micovi/stakee/models/inserts/README.md

<!-- Generated by `uv run stakee-build`. Edit the generator, not this file. -->

# Inserts

Drop-in trays that turn a crate into a kit: dev-board dock, solder station, parts grid.

[All models](../README.md) · 3 parts · rebuild with `uv run stakee-build --only inserts` · source: [`stakee/modules/inserts.py`](../../stakee/modules/inserts.py)

## Parts

| Preview | Part | Size (mm) | Material | Download |
| --- | --- | --- | --- | --- |
| Dev-board dock | **Dev-board dock**<br>Holds a Pi Zero / Zero 2 W and a Pico on locating pegs and an ESP32 DevKitC in an edge cradle, 10 mm off the floor so header tails never take the weight. | 120.9 × 78.9 × 14.4 | PLA or PETG | [STL](stl/dev-board-dock.stl) · [STEP](step/dev-board-dock.step) |
| Solder station insert | **Solder station insert**<br>Pockets for a 10 ml flux syringe (lying diagonally), a 40 mm wick reel on a spin axle with a feed slot, a 22 mm solder tube and a 30 mm tip-tinner tin. | 120.9 × 78.9 × 20 | PETG or ASA (it lives next to the iron); never rest the hot tip on any print | [STL](stl/solder-station.stl) · [STEP](step/solder-station.step) |
| Small-parts grid 4x4 | **Small-parts grid 4x4**<br>Lift-out tray of sixteen 18 mm cups with 5 mm scooped floors for SMD parts, screws and standoffs; swap whole trays between crates. | 78.9 × 78.9 × 14 | PLA or PETG | [STL](stl/parts-grid-2x2.stl) · [STEP](step/parts-grid-2x2.step) |

## Print notes

- **Dev-board dock**: Plate on the bed, no supports, 0.2 mm layers, 3 walls, 15% infill. Pegs are 2.35/1.7 mm: print slower for the top 3 mm or ream with a drill.
- **Solder station insert**: Upright, no supports, 3 walls, 10-15% infill. Round trough bottoms print as steep overhangs and come out fine; the 1 mm ribs between pockets need 0.4 mm nozzle.
- **Small-parts grid 4x4**: Upright, no supports, 2 walls, 15% infill.

## How it works

Drop-in inserts: trays that sit on a crate floor and turn a generic crate into a kit.

Every insert is modelled in its own frame (centered on XY, bottom at z = 0) and is
meant to sit at z = FLOOR_Z inside the crate it names. Inserts keep CLEARANCE per side
to the cavity walls and stay below the stacking seat (`size.lip_top - SEAT_DEPTH`),
so a crate or cap still stacks on top.
