micovi/stakee/models/baglib/step/cap-2x4.step

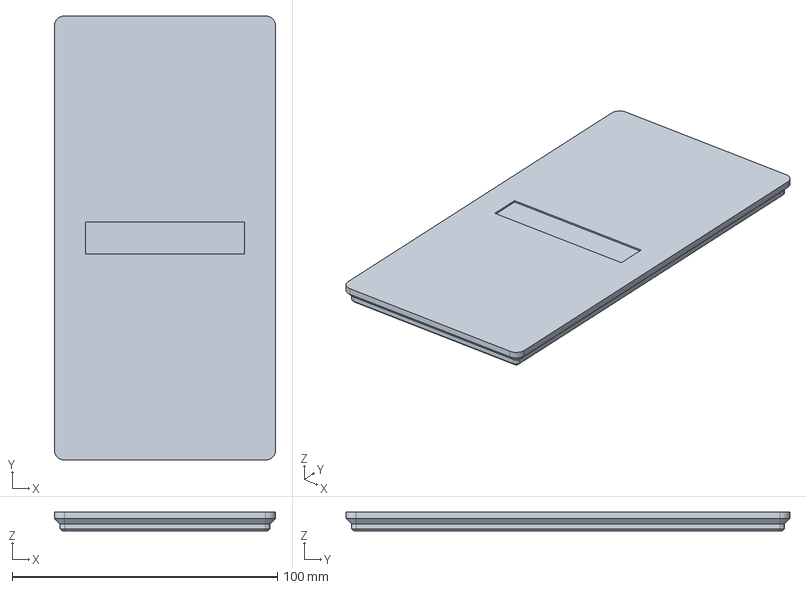
[picture p1: CAD file, 2026-10-02]
models/baglib/step/cap-2x4.step
83.5 x 167.5 x 7.15 mm
