micovi/stakee/models/calibration/step/lip-coupon-15.step

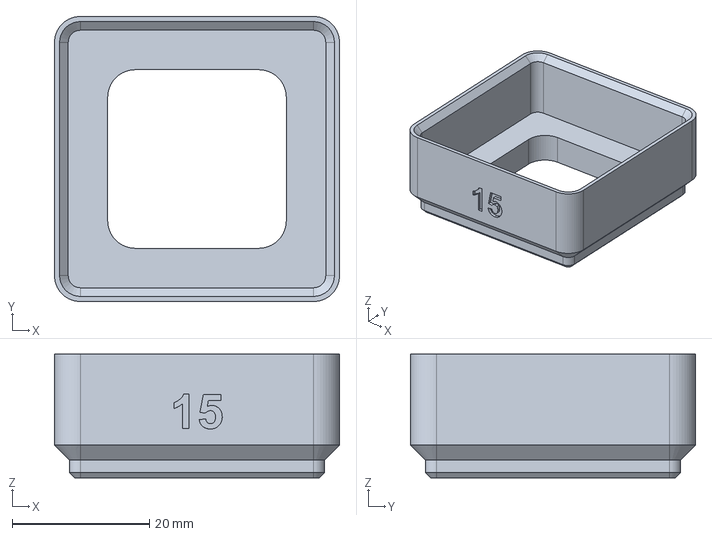
[picture p2: CAD file, 2026-10-02]
models/calibration/step/lip-coupon-15.step
41.5 x 41.5 x 18.0 mm
