micovi/stakee/models/crates/step/cap-2x2.step

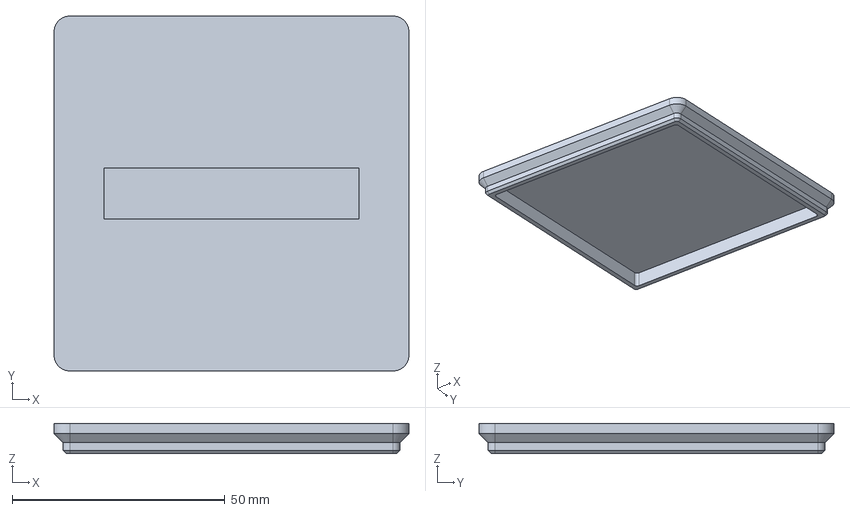
[picture p3: CAD file, 2026-10-02]
models/crates/step/cap-2x2.step
83.5 x 83.5 x 7.15 mm
