micovi/stakee/models/dividers/step/rail-x-3x2x6.step

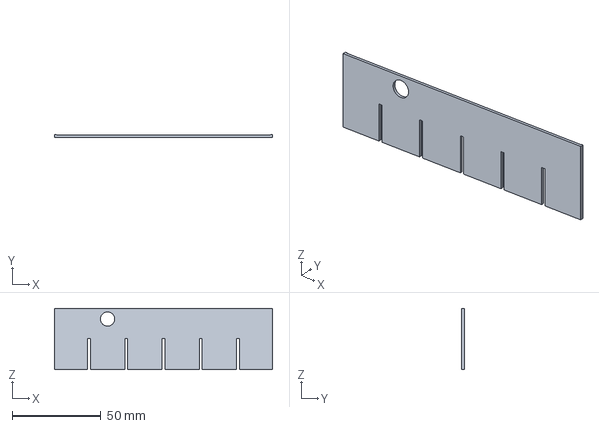
[picture p4: CAD file, 2026-10-02]
models/dividers/step/rail-x-3x2x6.step
122.7 x 1.50 x 34.5 mm
