micovi/stakee/models/drawers/step/sleeve-2x2x6.step

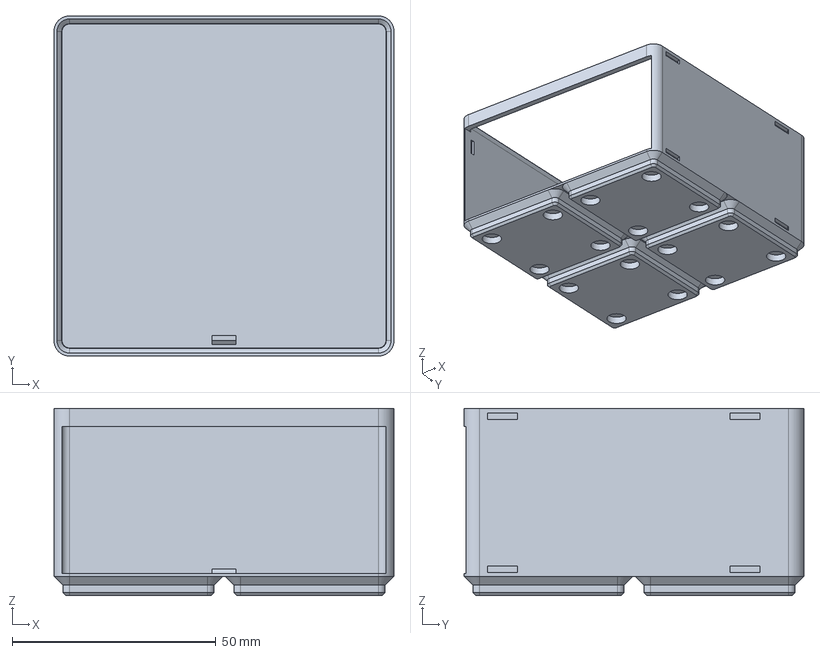
[picture p5: CAD file, 2026-10-02]
models/drawers/step/sleeve-2x2x6.step
83.5 x 83.5 x 46.0 mm
