micovi/stakee/models/esd/step/esd-crate-3x2x6.step

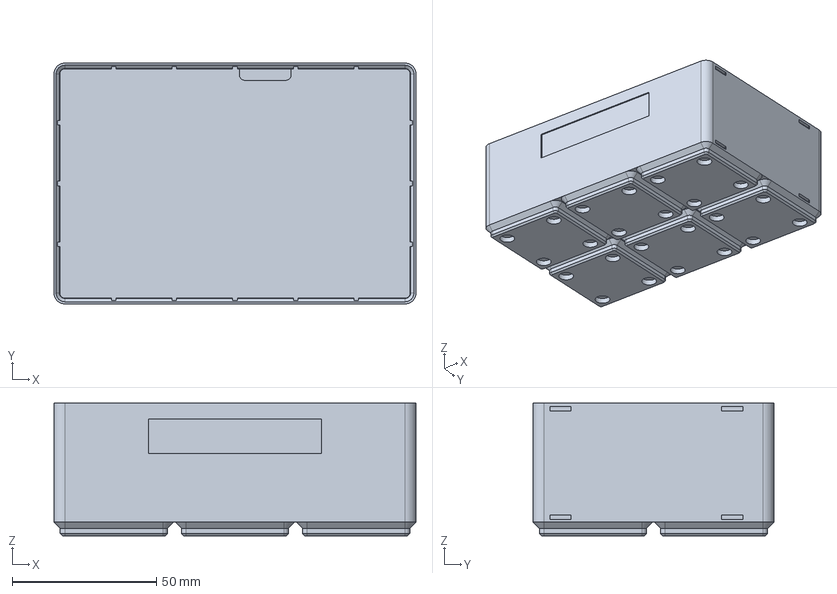
[picture p6: CAD file, 2026-10-02]
models/esd/step/esd-crate-3x2x6.step
125.5 x 83.5 x 46.0 mm
