micovi/stakee/models/inserts/step/parts-grid-2x2.step

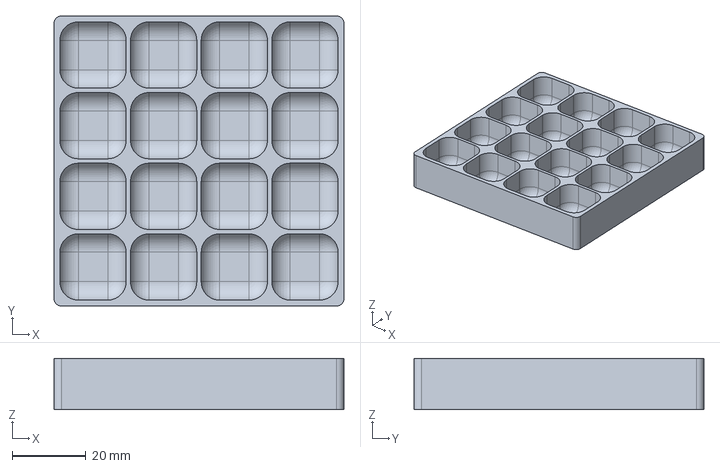
[picture p7: CAD file, 2026-10-02]
models/inserts/step/parts-grid-2x2.step
78.9 x 78.9 x 14.0 mm
