micovi/stakee/models/kit/step/nfc-label-tile.step

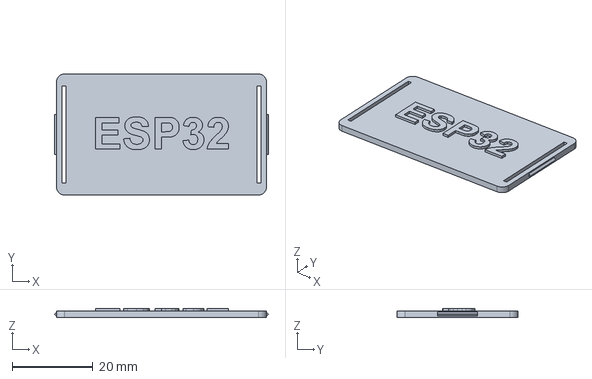
[picture p8: CAD file, 2026-10-02]
models/kit/step/nfc-label-tile.step
53.0 x 30.0 x 2.20 mm
