micovi/stakee/models/magtray/step/magtray-3x2.step

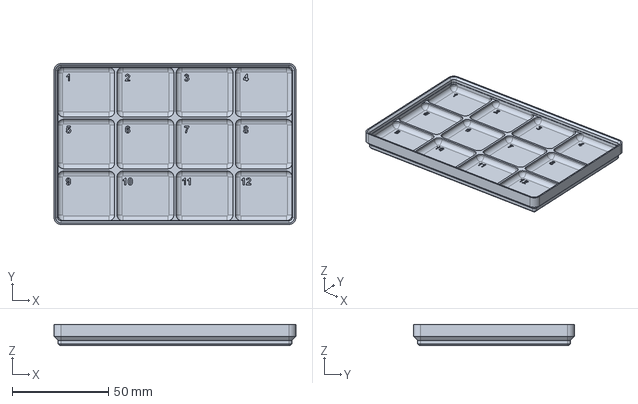
[picture p9: CAD file, 2026-10-02]
models/magtray/step/magtray-3x2.step
125.5 x 83.5 x 11.0 mm
