micovi/stakee/models/pocket/step/pocket-base-2x2x4.step

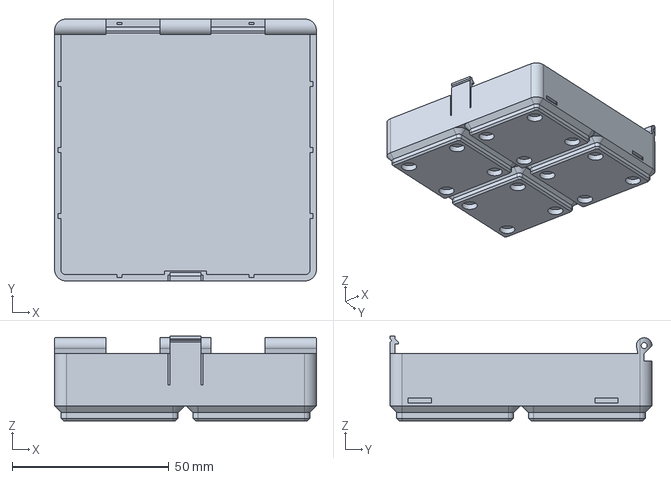
[picture p10: CAD file, 2026-10-02]
models/pocket/step/pocket-base-2x2x4.step
83.5 x 83.5 x 27.0 mm
