micovi/stakee/models/wallrail/step/wall-cleat-2.step

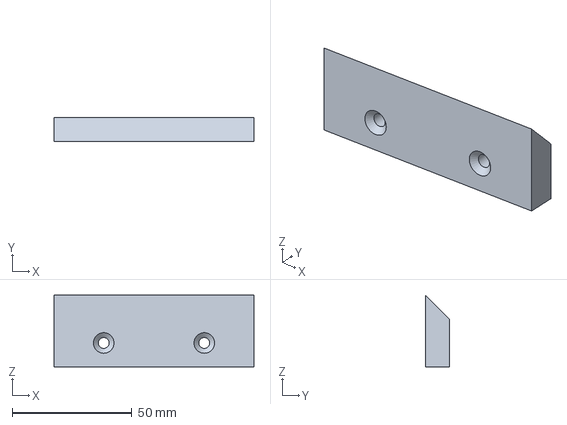
[picture p11: CAD file, 2026-10-02]
models/wallrail/step/wall-cleat-2.step
83.5 x 10.0 x 30.0 mm
