micovi/stakee/models/wirespool/step/wire-dispenser-4x2x9.step

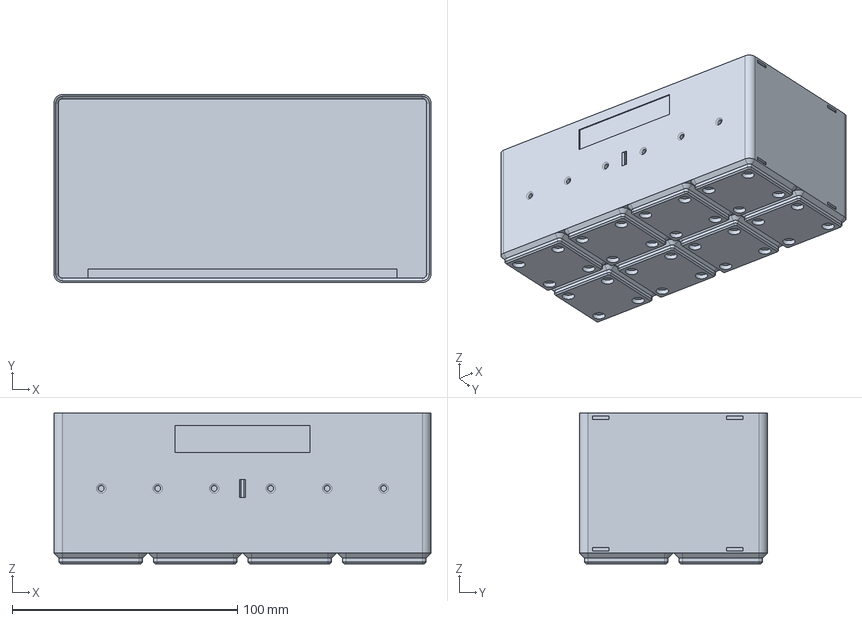
[picture p12: CAD file, 2026-10-02]
models/wirespool/step/wire-dispenser-4x2x9.step
167.5 x 83.5 x 67.0 mm
