micovi/stakee/models/baglib/step/card-4x-mcu.step

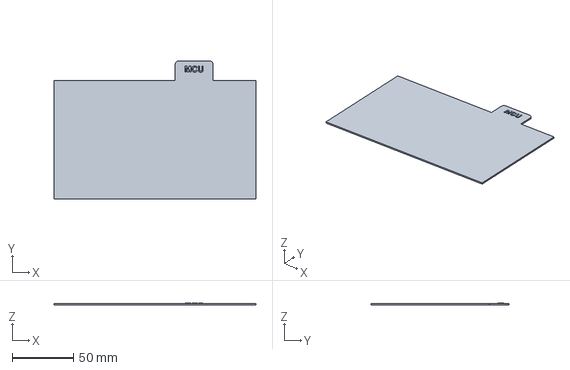
[picture p13: CAD file, 2026-10-02]
models/baglib/step/card-4x-mcu.step
164.7 x 112.9 x 1.60 mm
