micovi/stakee/models/calibration/step/slot-strip.step

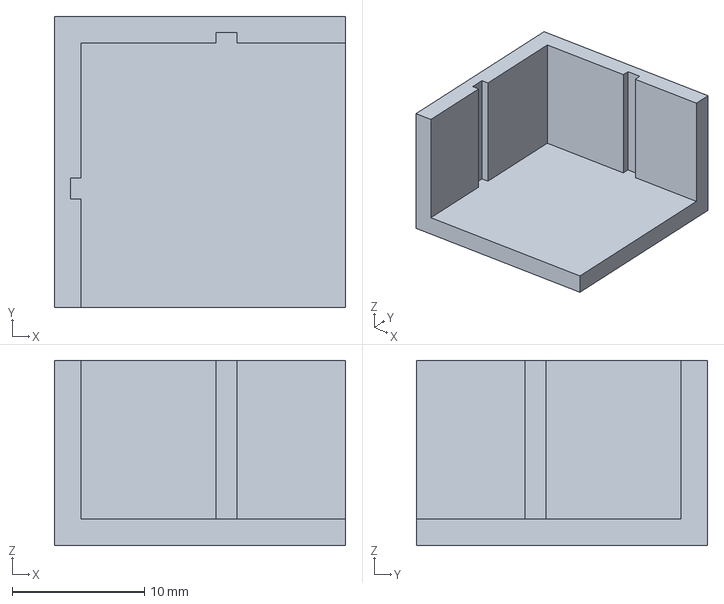
[picture p14: CAD file, 2026-10-02]
models/calibration/step/slot-strip.step
22.0 x 22.0 x 14.0 mm
