micovi/stakee/models/crates/step/crate-2x1x3.step

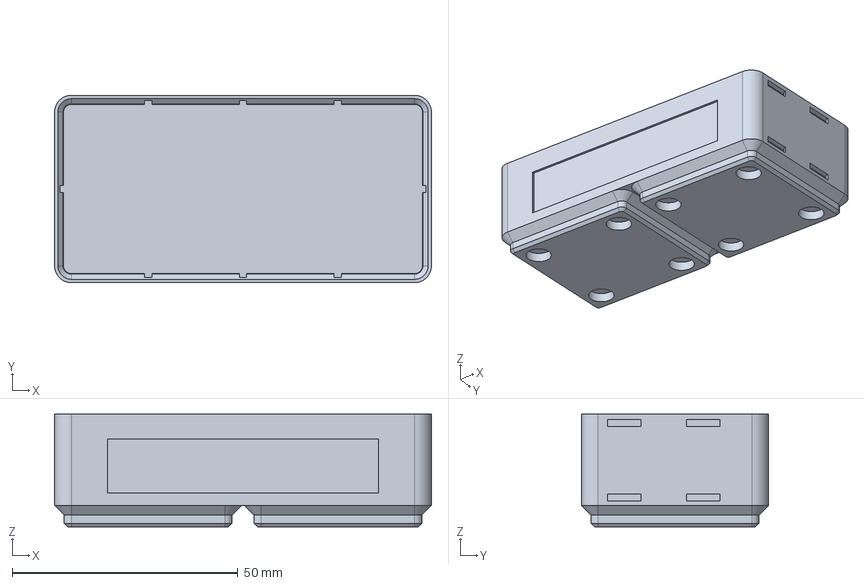
[picture p15: CAD file, 2026-10-02]
models/crates/step/crate-2x1x3.step
83.5 x 41.5 x 25.0 mm
