micovi/stakee/models/dividers/step/bridge-42-3x2x6.step

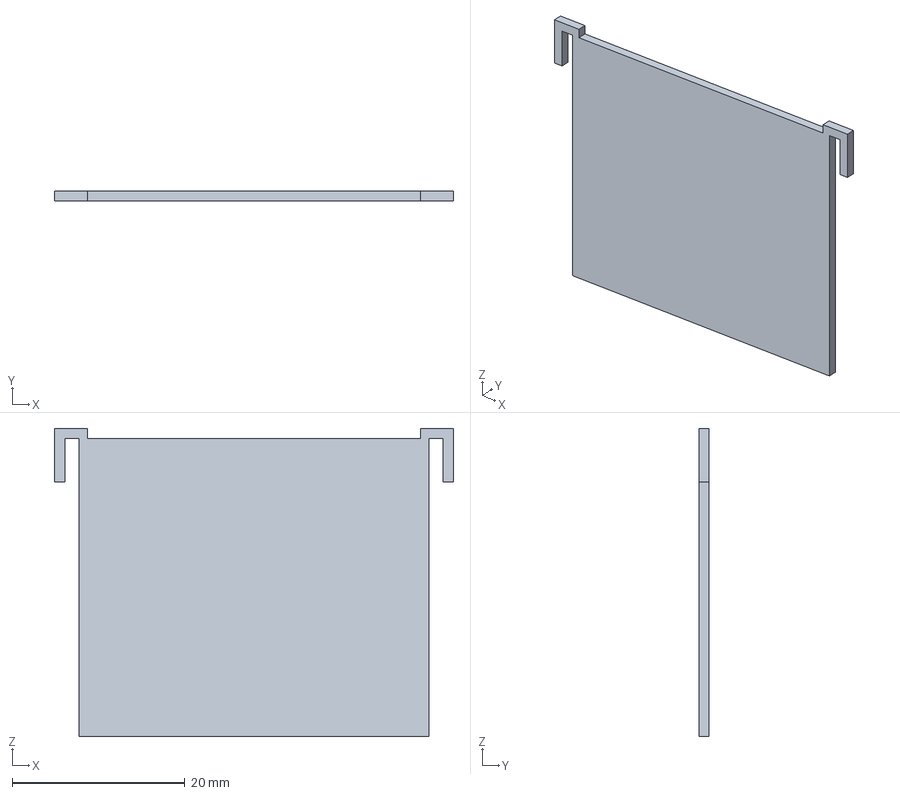
[picture p16: CAD file, 2026-10-02]
models/dividers/step/bridge-42-3x2x6.step
46.2 x 1.20 x 35.7 mm
