micovi/stakee/models/drawers/step/drawer-2x2x6.step

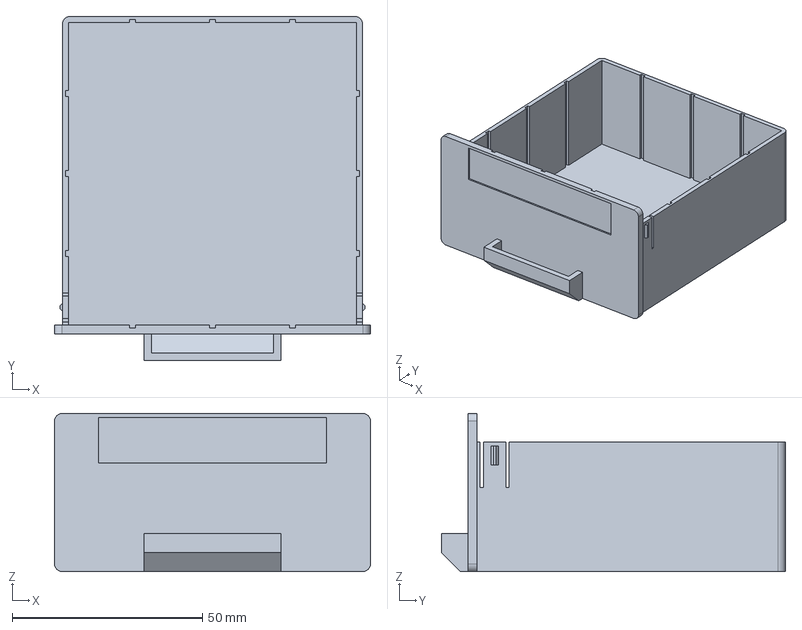
[picture p17: CAD file, 2026-10-02]
models/drawers/step/drawer-2x2x6.step
83.0 x 90.4 x 41.5 mm
