micovi/stakee/models/esd/step/esd-crate-2x2x3.step

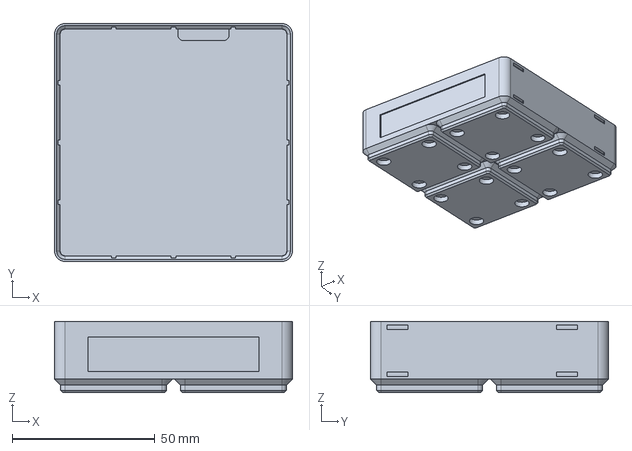
[picture p18: CAD file, 2026-10-02]
models/esd/step/esd-crate-2x2x3.step
83.5 x 83.5 x 25.0 mm
