micovi/stakee/models/inserts/step/dev-board-dock.step

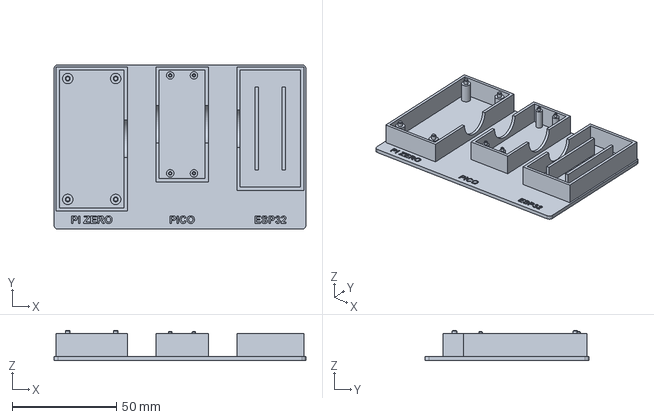
[picture p19: CAD file, 2026-10-02]
models/inserts/step/dev-board-dock.step
120.9 x 78.9 x 14.4 mm
