micovi/stakee/models/kit/step/tool-rack-cap-2x2.step

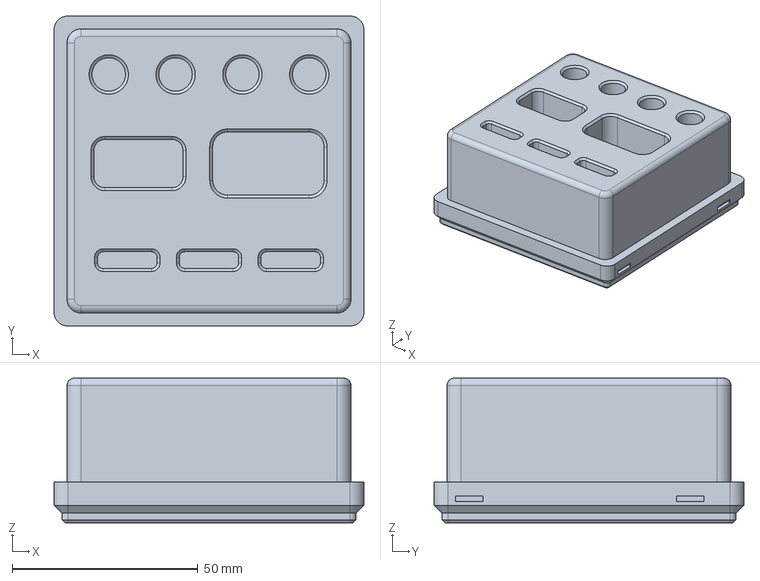
[picture p20: CAD file, 2026-10-02]
models/kit/step/tool-rack-cap-2x2.step
83.5 x 83.5 x 39.0 mm
