micovi/stakee/models/magtray/step/magtray-2x2.step

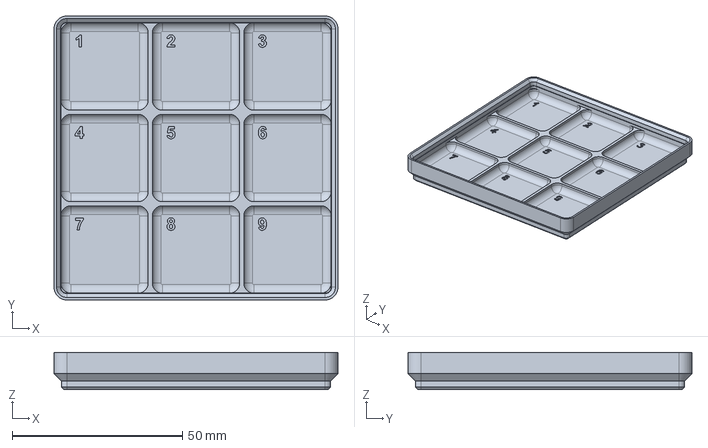
[picture p21: CAD file, 2026-10-02]
models/magtray/step/magtray-2x2.step
83.5 x 83.5 x 11.0 mm
