micovi/stakee/models/pocket/step/pocket-base-2x1x4.step

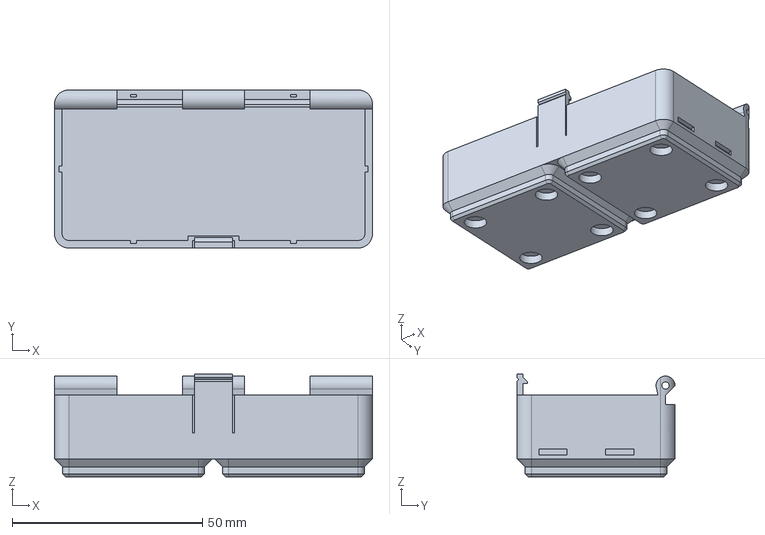
[picture p22: CAD file, 2026-10-02]
models/pocket/step/pocket-base-2x1x4.step
83.5 x 41.5 x 27.0 mm
