micovi/stakee/models/wallrail/step/wall-cleat-4.step

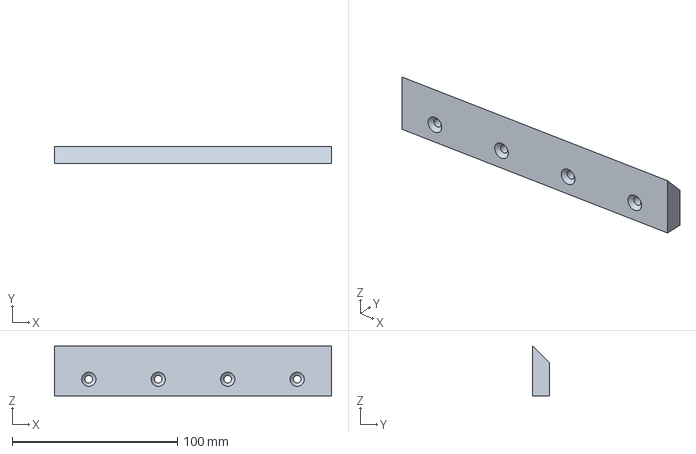
[picture p23: CAD file, 2026-10-02]
models/wallrail/step/wall-cleat-4.step
167.5 x 10.0 x 30.0 mm
