micovi/stakee/models/wirespool/step/wire-cradle-frame-4x2x9.step

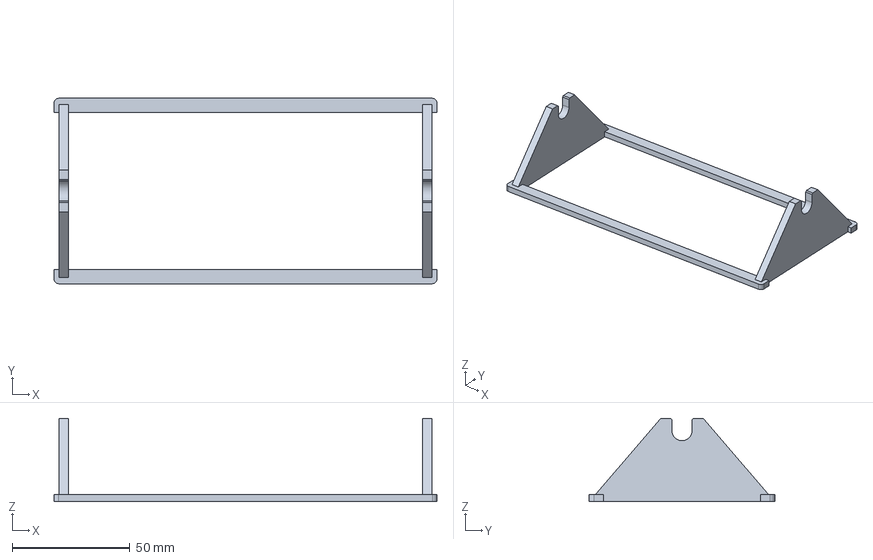
[picture p24: CAD file, 2026-10-02]
models/wirespool/step/wire-cradle-frame-4x2x9.step
162.9 x 78.9 x 35.5 mm
