micovi/stakee/models/baglib/step/card-2x-res.step

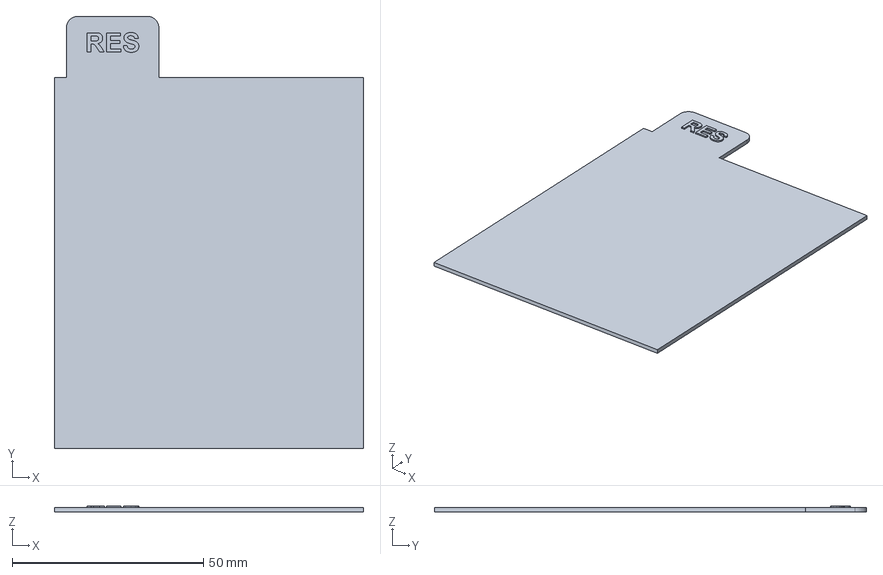
[picture p25: CAD file, 2026-10-02]
models/baglib/step/card-2x-res.step
80.7 x 112.9 x 1.60 mm
