micovi/stakee/models/calibration/step/lip-probe.step

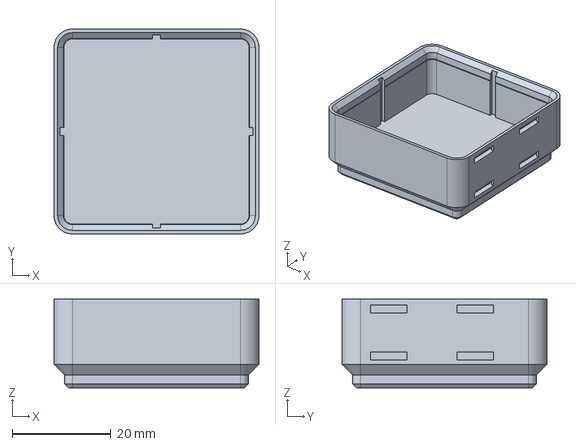
[picture p26: CAD file, 2026-10-02]
models/calibration/step/lip-probe.step
41.5 x 41.5 x 18.0 mm
