micovi/stakee/models/drawers/step/rail-y-drawer-2x2x6.step

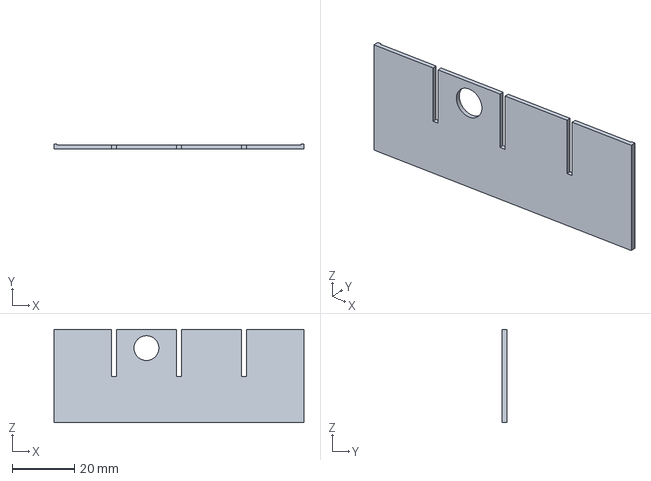
[picture p27: CAD file, 2026-10-02]
models/drawers/step/rail-y-drawer-2x2x6.step
80.6 x 1.50 x 30.0 mm
