micovi/stakee/models/esd/step/esd-crate-2x2x6.step

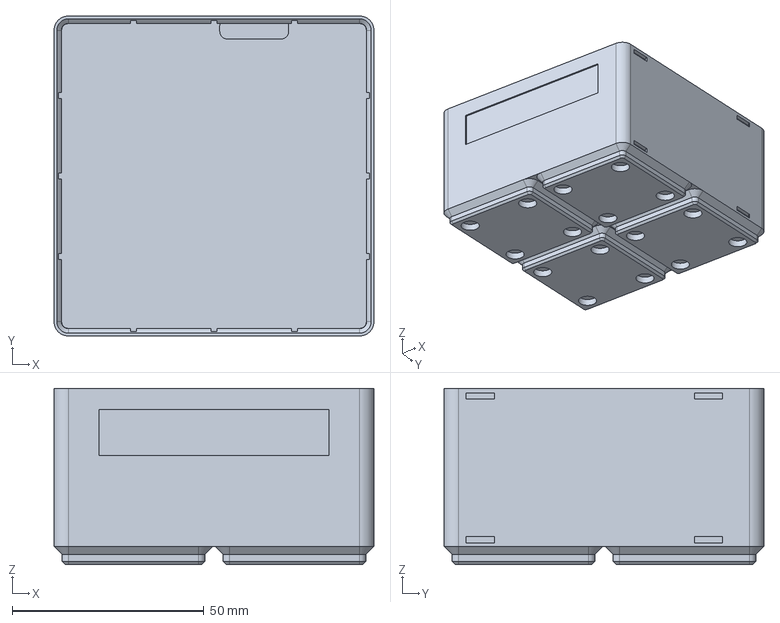
[picture p28: CAD file, 2026-10-02]
models/esd/step/esd-crate-2x2x6.step
83.5 x 83.5 x 46.0 mm
