micovi/stakee/models/inserts/step/solder-station.step

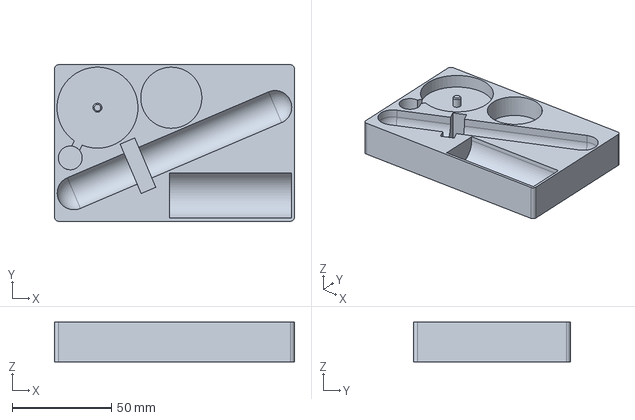
[picture p29: CAD file, 2026-10-02]
models/inserts/step/solder-station.step
120.9 x 78.9 x 20.0 mm
