micovi/stakee/models/pocket/step/pocket-divider-2x2.step

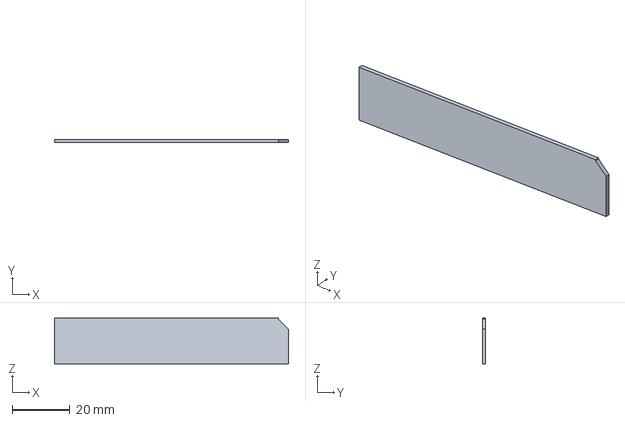
[picture p31: CAD file, 2026-10-02]
models/pocket/step/pocket-divider-2x2.step
80.7 x 1.20 x 15.7 mm
