micovi/stakee/models/wallrail/step/shelf-2x1.step

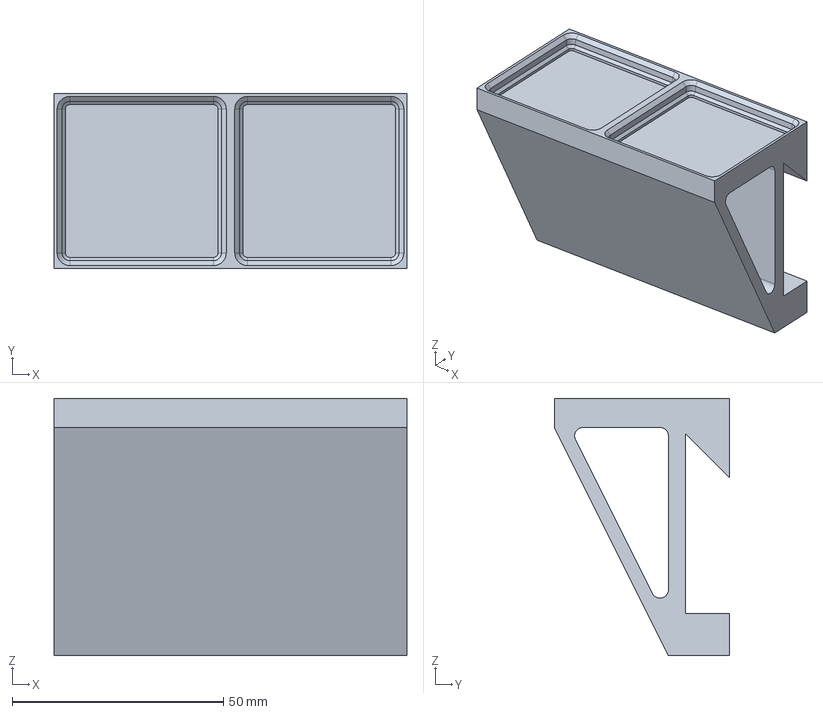
[picture p32: CAD file, 2026-10-02]
models/wallrail/step/shelf-2x1.step
83.5 x 41.5 x 60.9 mm
