micovi/stakee/models/wirespool/step/wire-axle-8mm.step

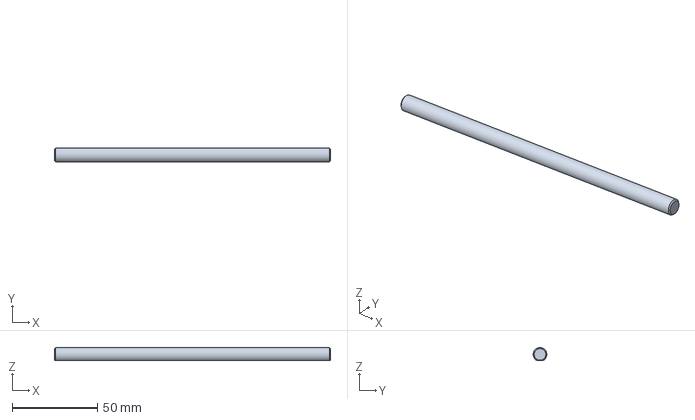
[picture p33: CAD file, 2026-10-02]
models/wirespool/step/wire-axle-8mm.step
161.5 x 7.99 x 7.49 mm
