micovi/stakee/models/calibration/step/lip-coupon-35.step

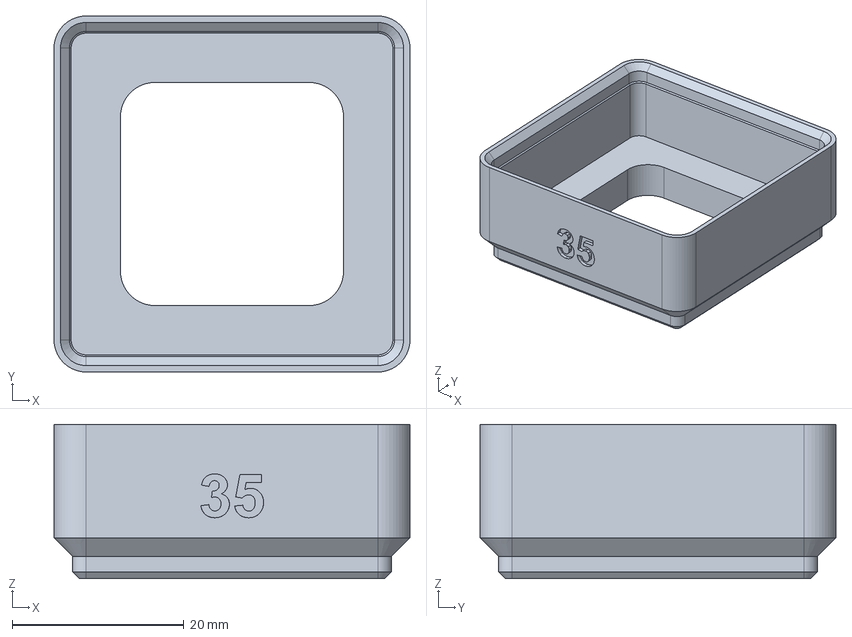
[picture p34: CAD file, 2026-10-02]
models/calibration/step/lip-coupon-35.step
41.5 x 41.5 x 18.0 mm
