micovi/stakee/models/dividers/step/rail-y-2x2x3.step

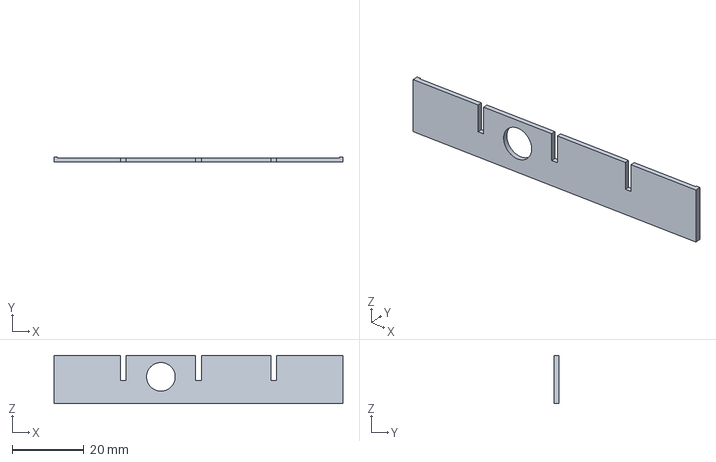
[picture p35: CAD file, 2026-10-02]
models/dividers/step/rail-y-2x2x3.step
80.7 x 1.50 x 13.5 mm
