micovi/stakee/models/drawers/step/drawer-2x2x3.step

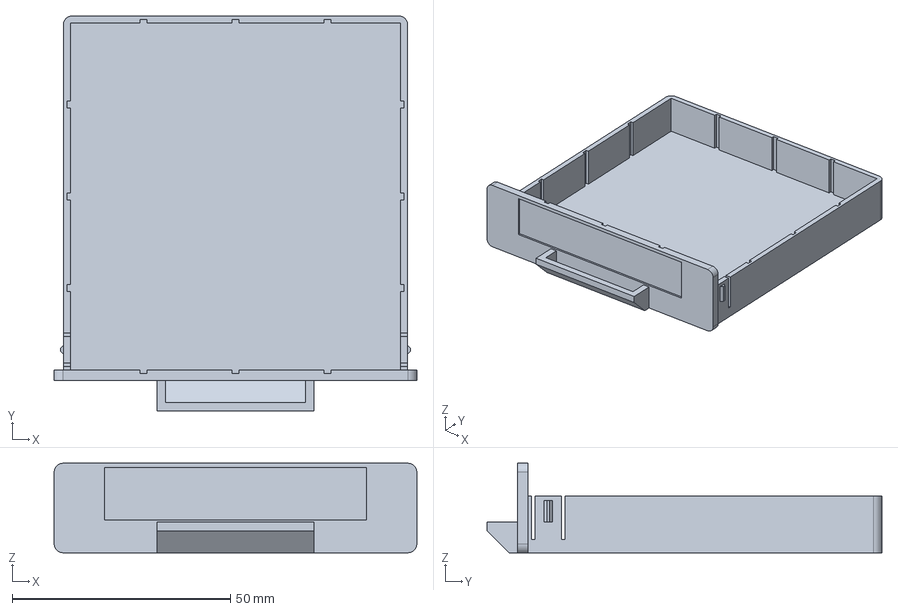
[picture p36: CAD file, 2026-10-02]
models/drawers/step/drawer-2x2x3.step
83.0 x 90.4 x 20.5 mm
