micovi/stakee/models/kit/step/tote-cap-2x2.step

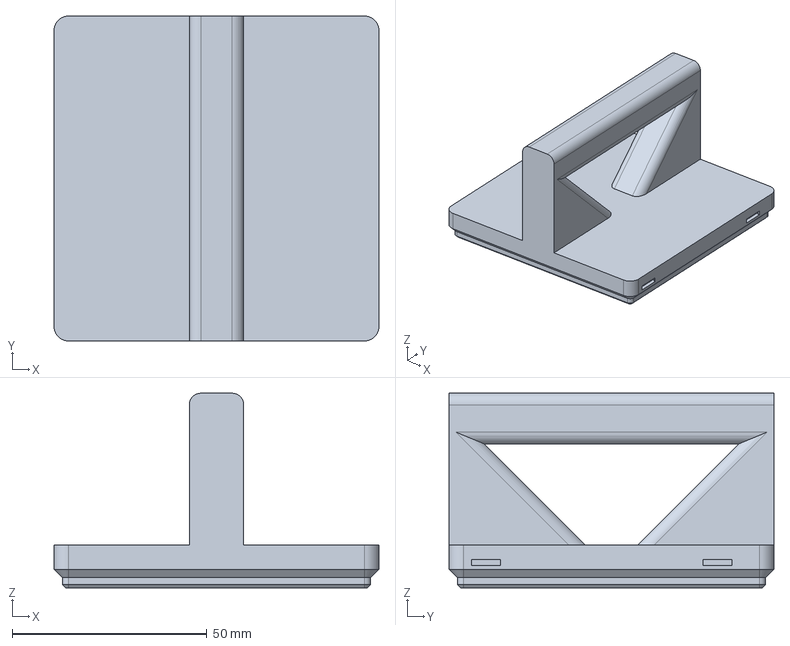
[picture p37: CAD file, 2026-10-02]
models/kit/step/tote-cap-2x2.step
83.5 x 83.5 x 50.0 mm
