micovi/stakee/models/pocket/step/pocket-lid-2x1.step

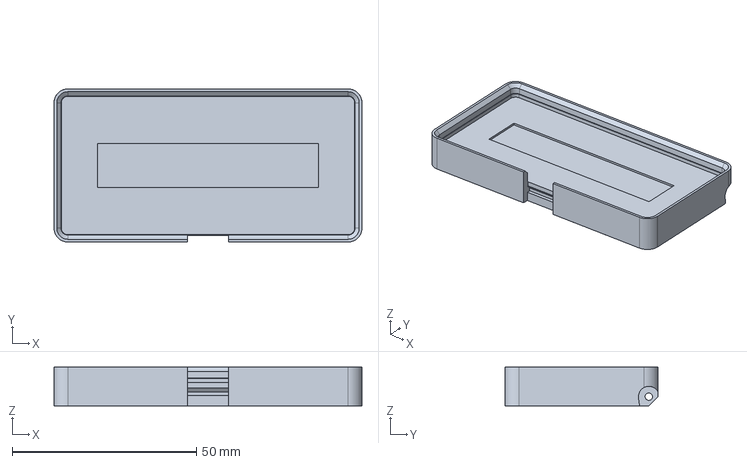
[picture p38: CAD file, 2026-10-02]
models/pocket/step/pocket-lid-2x1.step
83.5 x 41.5 x 10.5 mm
