micovi/stakee/models/wallrail/step/shelf-3x2.step

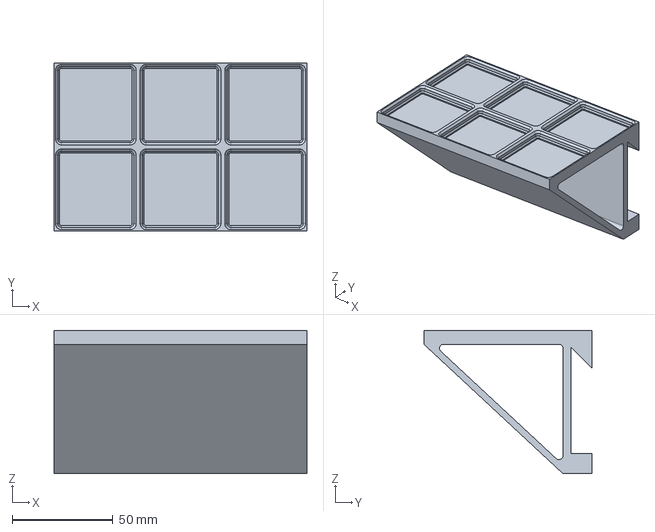
[picture p39: CAD file, 2026-10-02]
models/wallrail/step/shelf-3x2.step
125.5 x 83.5 x 71.1 mm
