micovi/stakee/models/crates/step/cap-2x1.step

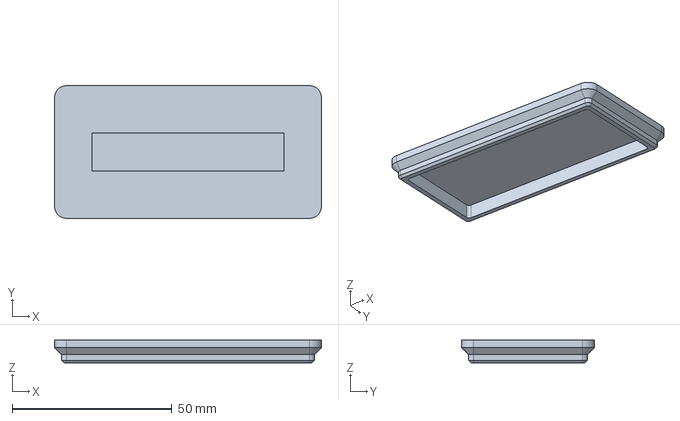
[picture p40: CAD file, 2026-10-02]
models/crates/step/cap-2x1.step
83.5 x 41.5 x 7.15 mm
