micovi/stakee/models/dividers/step/hook-42-2x2x3.step

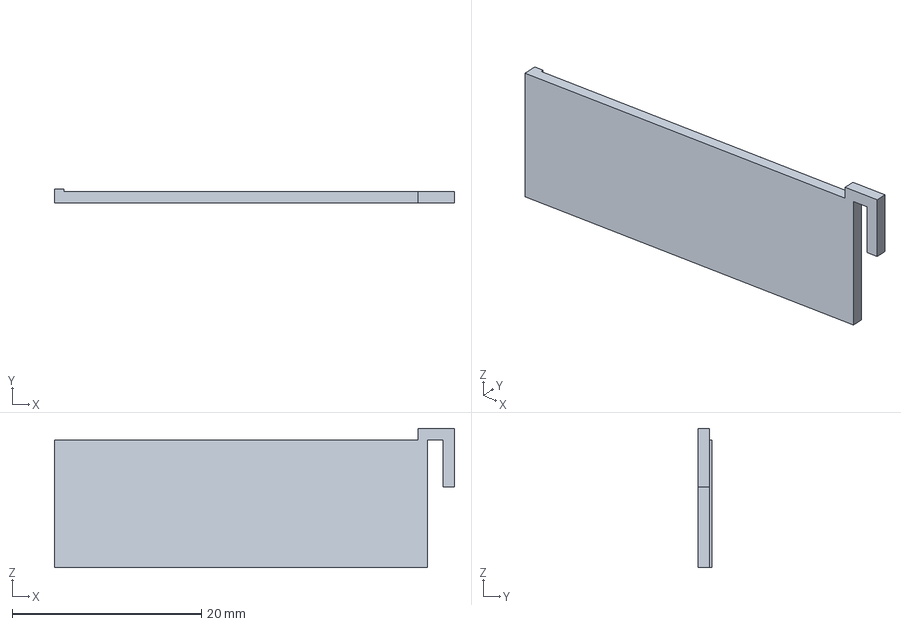
[picture p41: CAD file, 2026-10-02]
models/dividers/step/hook-42-2x2x3.step
42.3 x 1.50 x 14.7 mm
