micovi/stakee/models/drawers/step/rail-x-drawer-2x2x3.step

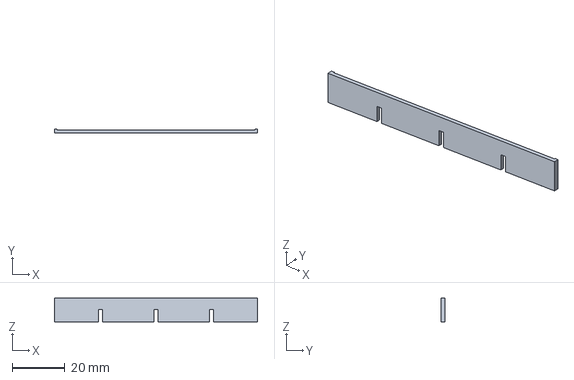
[picture p42: CAD file, 2026-10-02]
models/drawers/step/rail-x-drawer-2x2x3.step
76.8 x 1.50 x 9.00 mm
