micovi/stakee/models/kit/step/nfc-cap-2x2.step

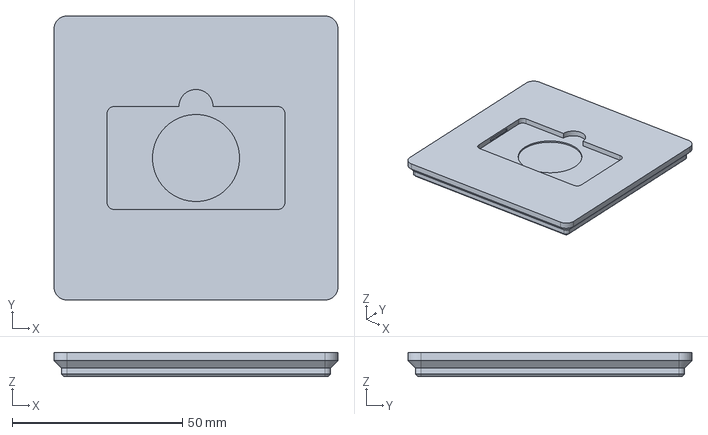
[picture p43: CAD file, 2026-10-02]
models/kit/step/nfc-cap-2x2.step
83.5 x 83.5 x 7.15 mm
