micovi/stakee/models/pocket/step/pocket-divider-2x1.step

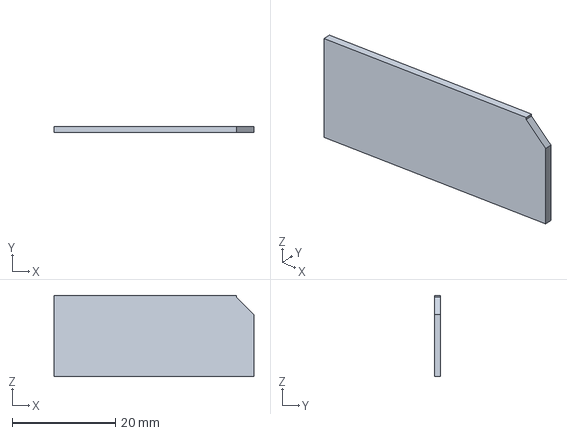
[picture p44: CAD file, 2026-10-02]
models/pocket/step/pocket-divider-2x1.step
38.7 x 1.20 x 15.7 mm
