micovi/stakee/models/wallrail/step/shelf-4x1.step

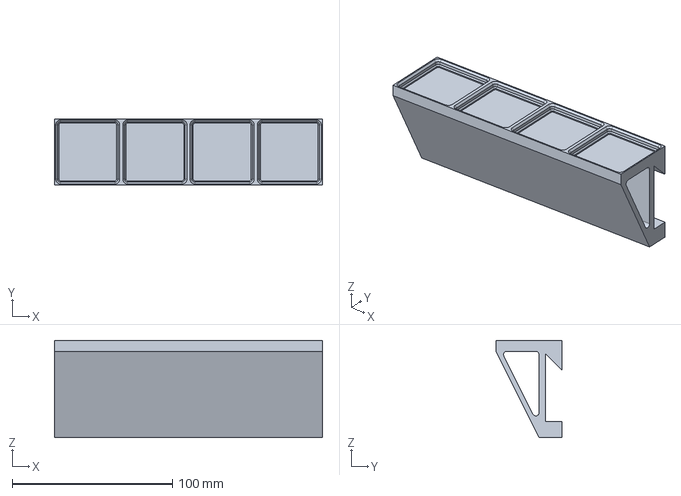
[picture p45: CAD file, 2026-10-02]
models/wallrail/step/shelf-4x1.step
167.5 x 41.5 x 60.9 mm
