micovi/stakee/models/calibration/step/slot-samples.step

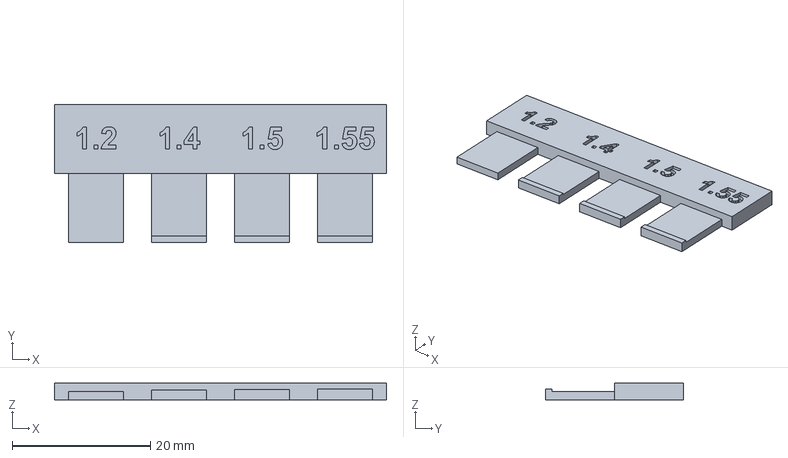
[picture p46: CAD file, 2026-10-02]
models/calibration/step/slot-samples.step
48.0 x 20.0 x 2.40 mm
