micovi/stakee/models/crates/step/cap-1x1.step

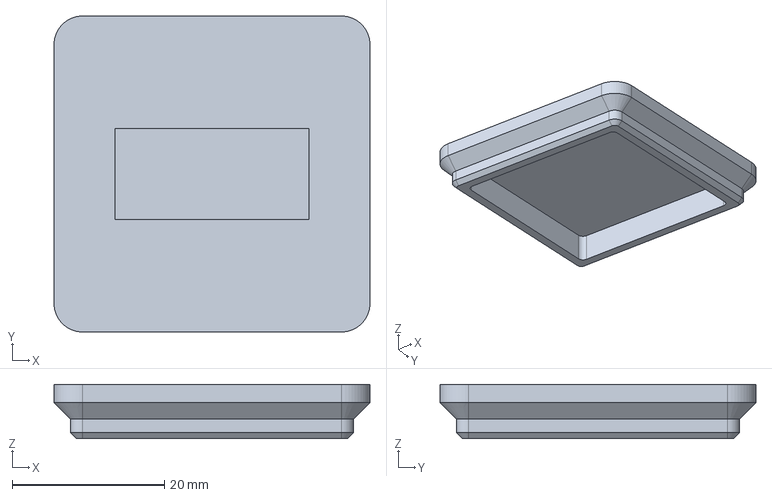
[picture p47: CAD file, 2026-10-02]
models/crates/step/cap-1x1.step
41.5 x 41.5 x 7.15 mm
