micovi/stakee/models/dividers/step/hook-21-2x2x6.step

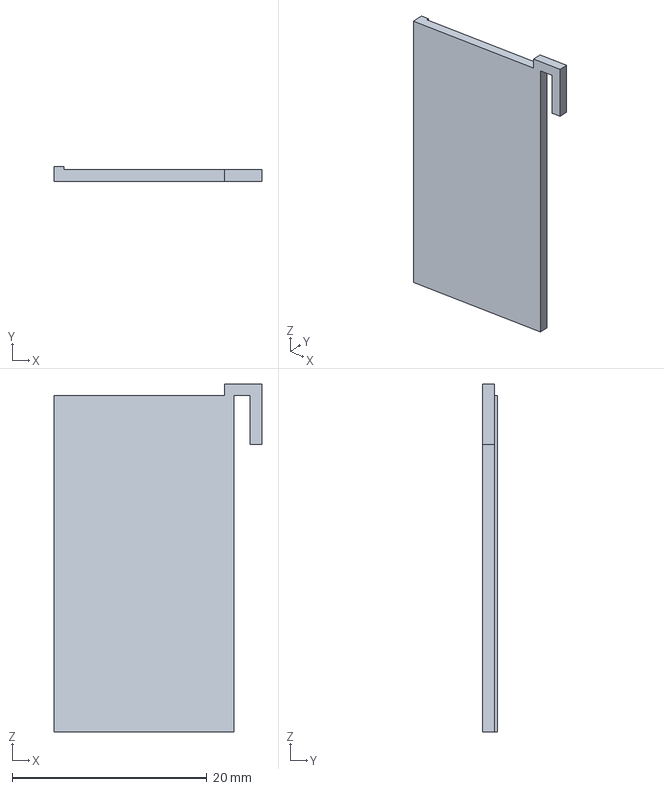
[picture p48: CAD file, 2026-10-02]
models/dividers/step/hook-21-2x2x6.step
21.3 x 1.50 x 35.7 mm
