micovi/stakee/models/drawers/step/sleeve-2x2x3.step

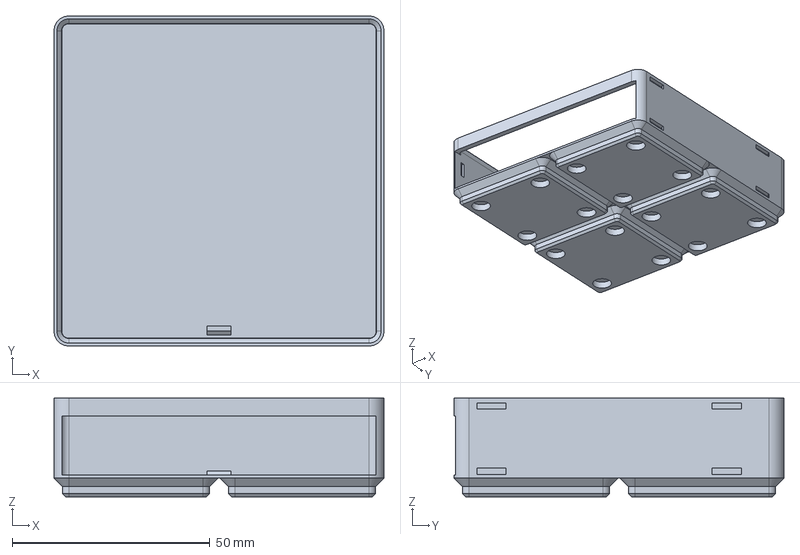
[picture p49: CAD file, 2026-10-02]
models/drawers/step/sleeve-2x2x3.step
83.5 x 83.5 x 25.0 mm
