micovi/stakee/models/kit/step/stack-clip.step

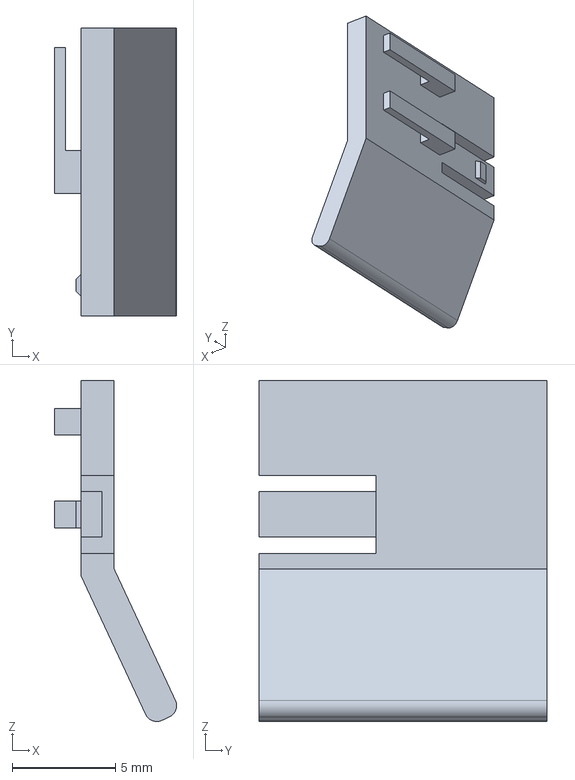
[picture p50: CAD file, 2026-10-02]
models/kit/step/stack-clip.step
5.93 x 14.0 x 16.6 mm
