micovi/stakee/models/pocket/step/pocket-lid-2x2.step

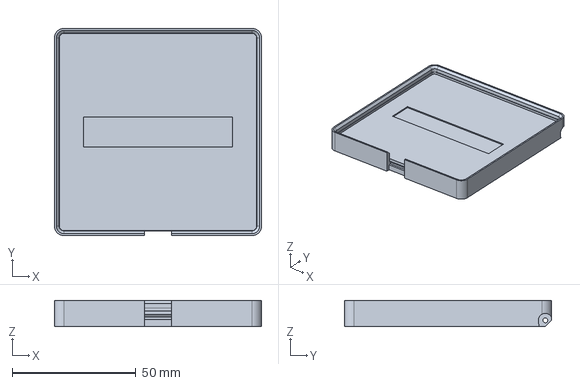
[picture p51: CAD file, 2026-10-02]
models/pocket/step/pocket-lid-2x2.step
83.5 x 83.5 x 10.5 mm
