micovi/stakee/models/wallrail/step/shelf-2x2.step

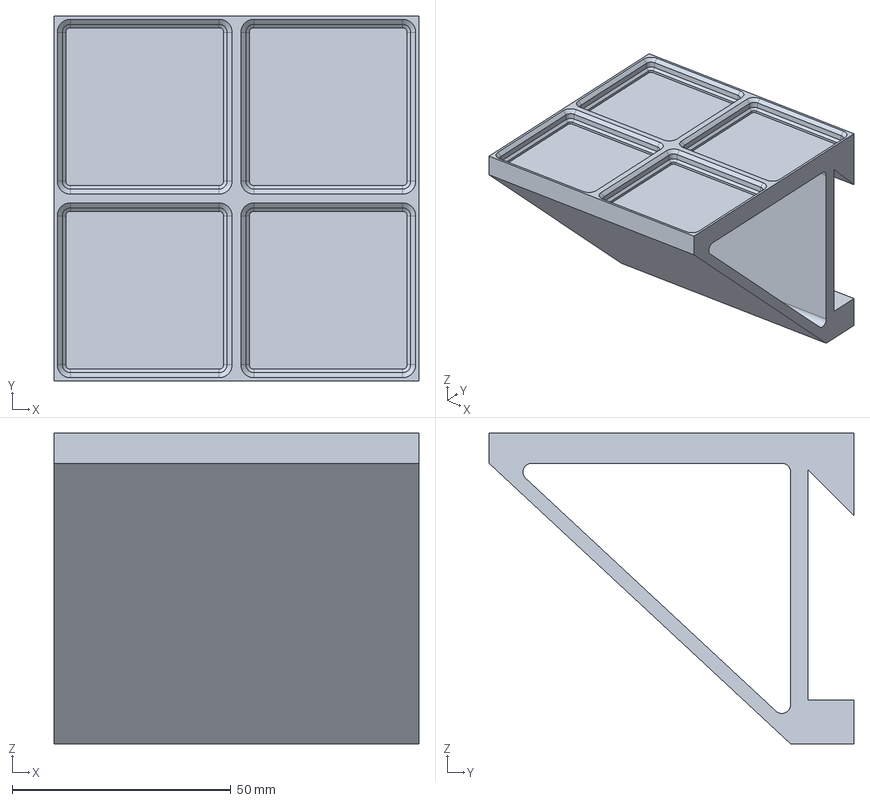
[picture p52: CAD file, 2026-10-02]
models/wallrail/step/shelf-2x2.step
83.5 x 83.5 x 71.1 mm
