micovi/stakee/models/dividers/step/hook-21-2x2x3.step

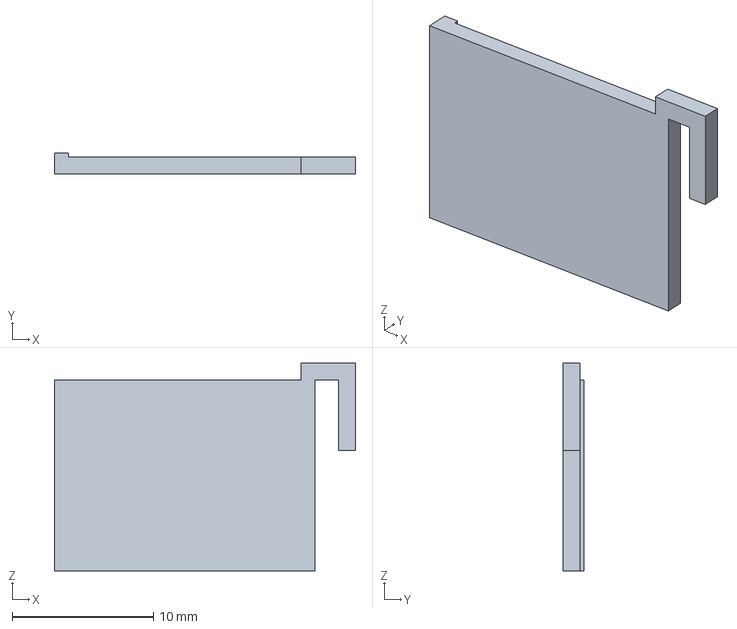
[picture p53: CAD file, 2026-10-02]
models/dividers/step/hook-21-2x2x3.step
21.3 x 1.50 x 14.7 mm
