micovi/stakee/models/drawers/step/rail-x-drawer-2x2x6.step

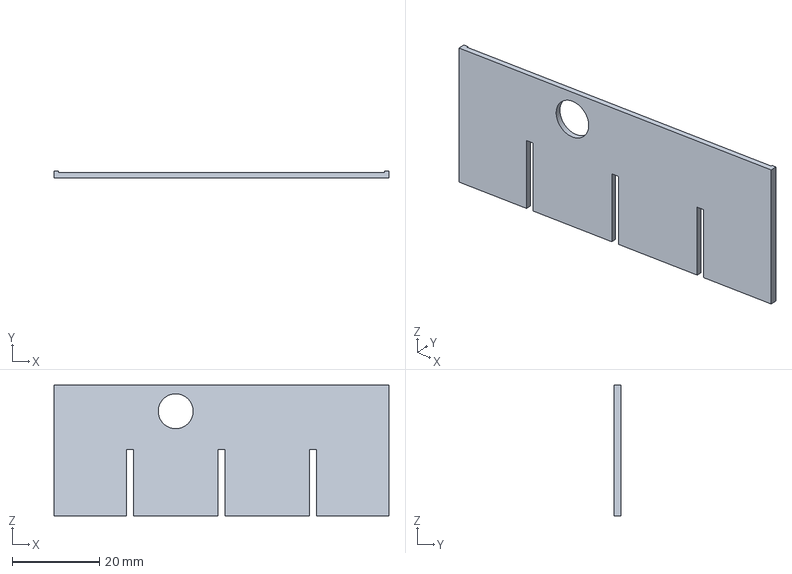
[picture p54: CAD file, 2026-10-02]
models/drawers/step/rail-x-drawer-2x2x6.step
76.8 x 1.50 x 30.0 mm
