micovi/stakee/models/crates/step/cap-3x2.step

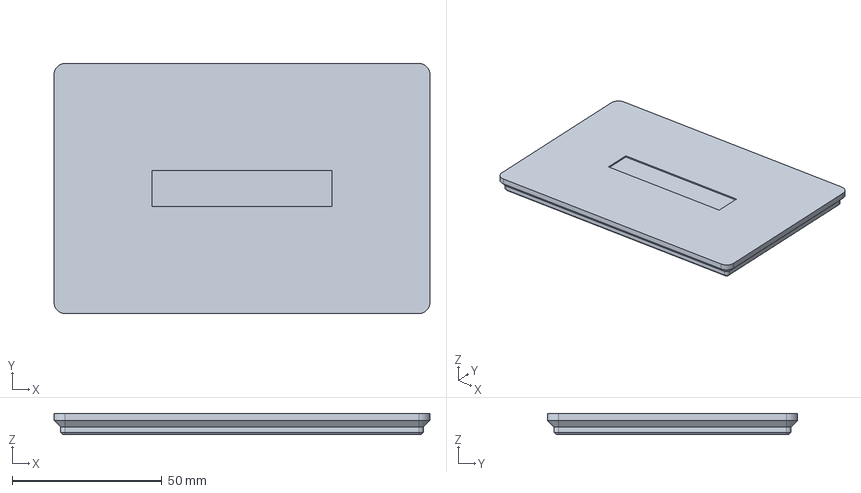
[picture p55: CAD file, 2026-10-02]
models/crates/step/cap-3x2.step
125.5 x 83.5 x 7.15 mm
