micovi/stakee/models/dividers/step/bridge-21-2x2x6.step

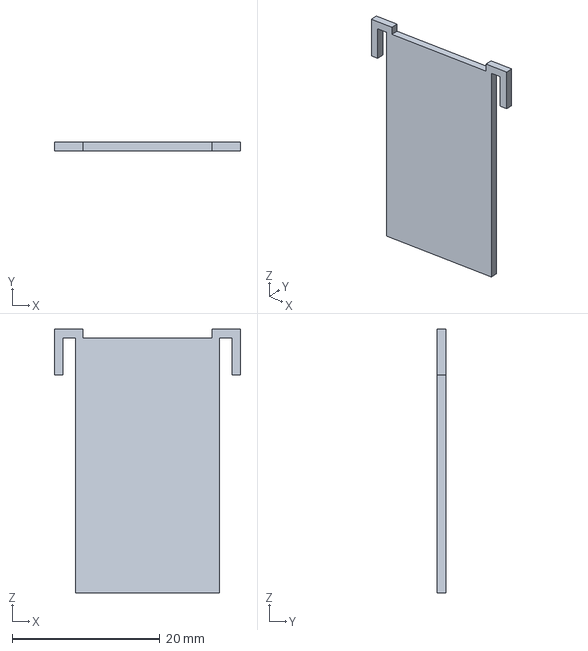
[picture p56: CAD file, 2026-10-02]
models/dividers/step/bridge-21-2x2x6.step
25.2 x 1.20 x 35.7 mm
