micovi/stakee/models/drawers/step/rail-y-drawer-2x2x3.step

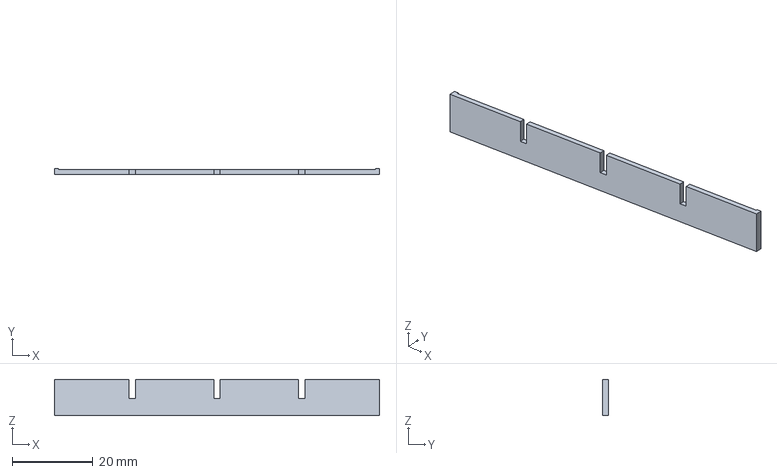
[picture p57: CAD file, 2026-10-02]
models/drawers/step/rail-y-drawer-2x2x3.step
80.6 x 1.50 x 9.00 mm
