micovi/stakee/models/baglib/step/follower-4x.step

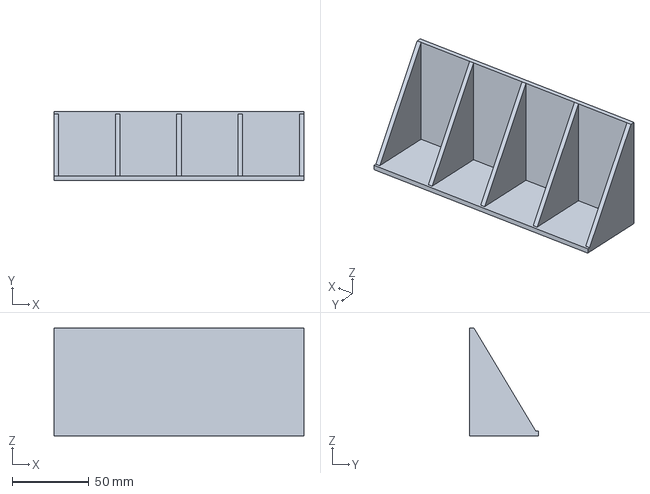
[picture p58: CAD file, 2026-10-02]
models/baglib/step/follower-4x.step
162.5 x 45.0 x 70.0 mm
