micovi/stakee/models/crates/step/crate-1x1x3.step

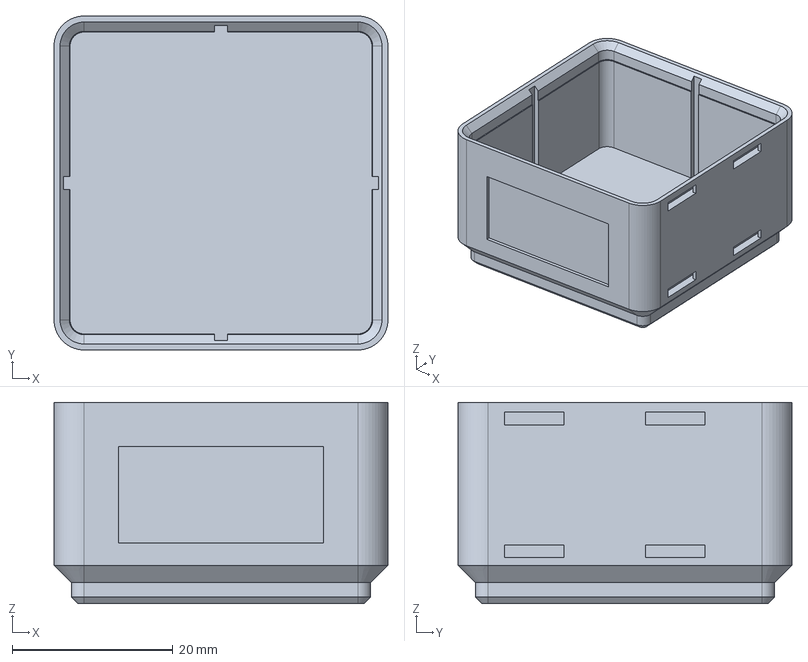
[picture p59: CAD file, 2026-10-02]
models/crates/step/crate-1x1x3.step
41.5 x 41.5 x 25.0 mm
