micovi/stakee/models/dividers/step/hook-42-3x2x6.step

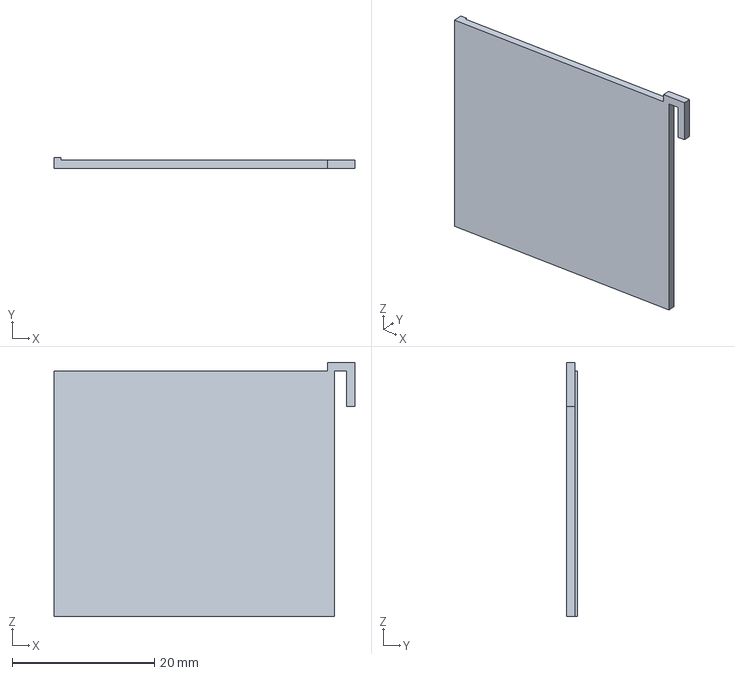
[picture p60: CAD file, 2026-10-02]
models/dividers/step/hook-42-3x2x6.step
42.3 x 1.50 x 35.7 mm
