micovi/stakee/models/dividers/step/rail-y-2x2x6.step

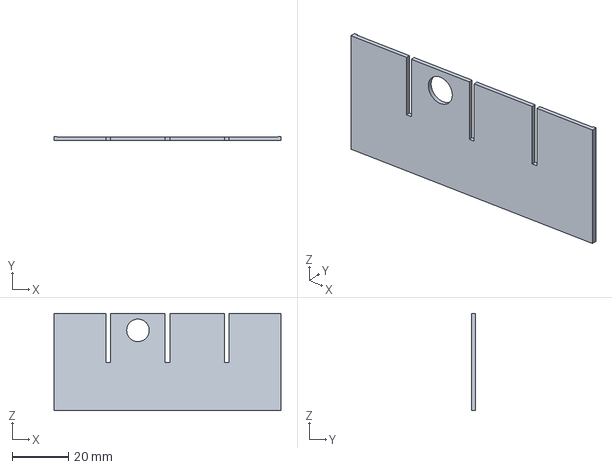
[picture p61: CAD file, 2026-10-02]
models/dividers/step/rail-y-2x2x6.step
80.7 x 1.50 x 34.5 mm
