micovi/stakee/models/baglib/step/follower-2x.step

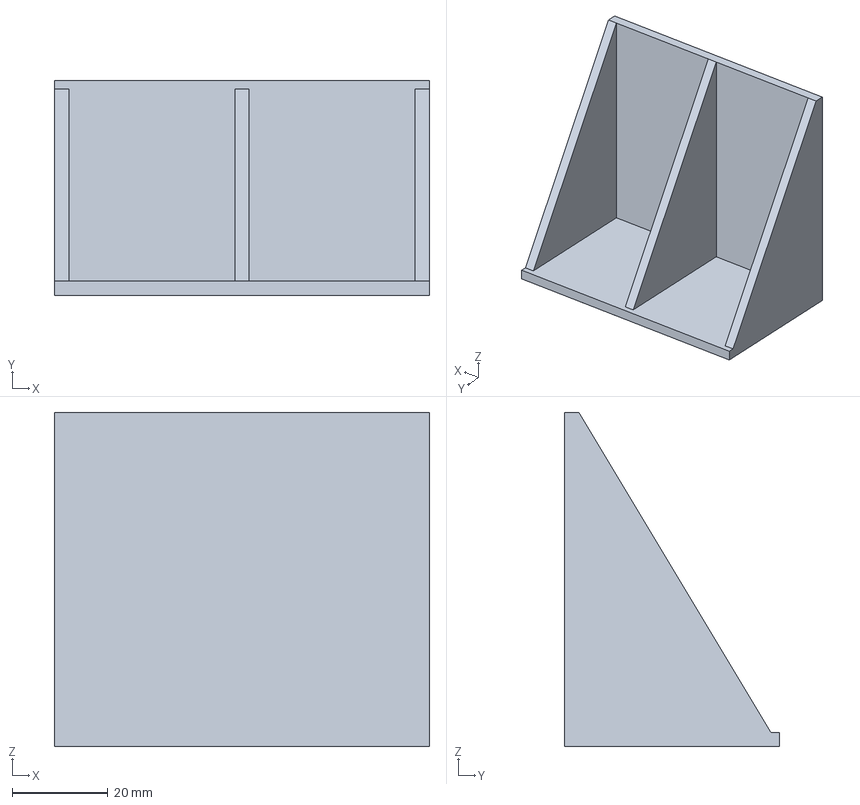
[picture p62: CAD file, 2026-10-02]
models/baglib/step/follower-2x.step
78.5 x 45.0 x 70.0 mm
