micovi/stakee/models/baglib/step/cap-4x3.step

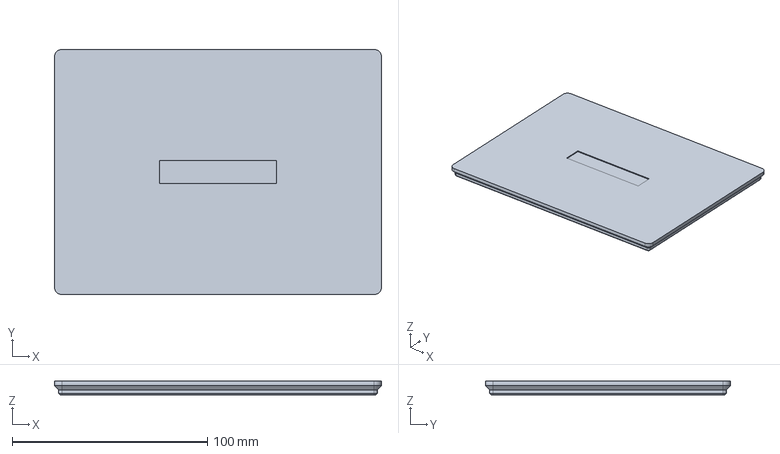
[picture p64: CAD file, 2026-10-02]
models/baglib/step/cap-4x3.step
167.5 x 125.5 x 7.15 mm
