micovi/stakee/models/dividers/step/bridge-21-2x2x3.step

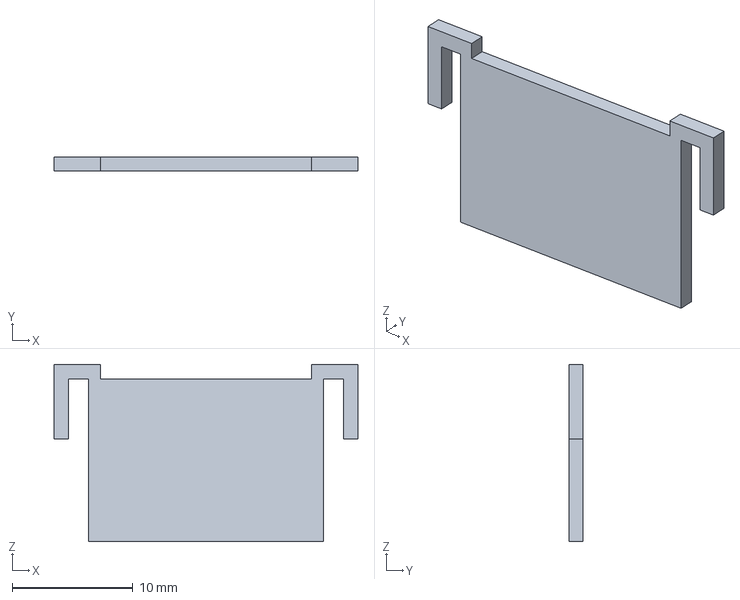
[picture p65: CAD file, 2026-10-02]
models/dividers/step/bridge-21-2x2x3.step
25.2 x 1.20 x 14.7 mm
