micovi/stakee/models/baglib/step/crate-2x4x17.step

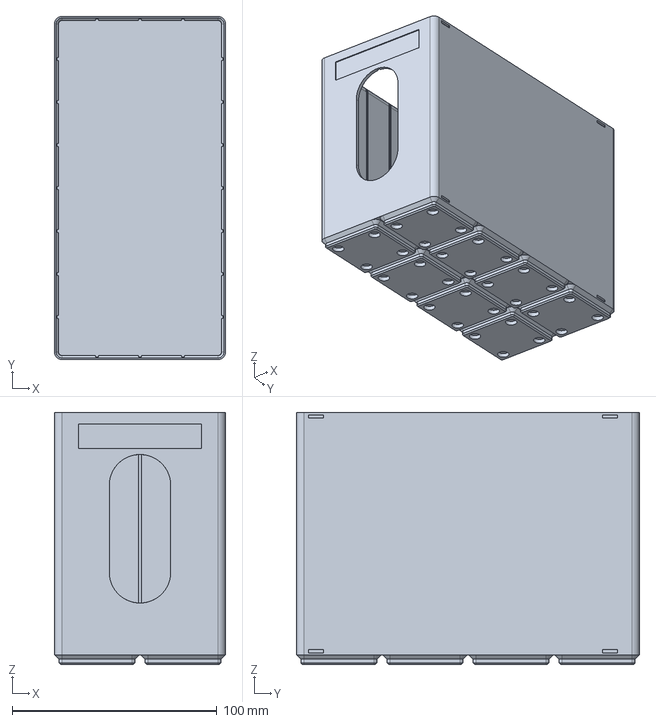
[picture p66: CAD file, 2026-10-02]
models/baglib/step/crate-2x4x17.step
83.5 x 167.5 x 123.0 mm
