micovi/stakee/models/baglib/step/crate-4x3x17.step

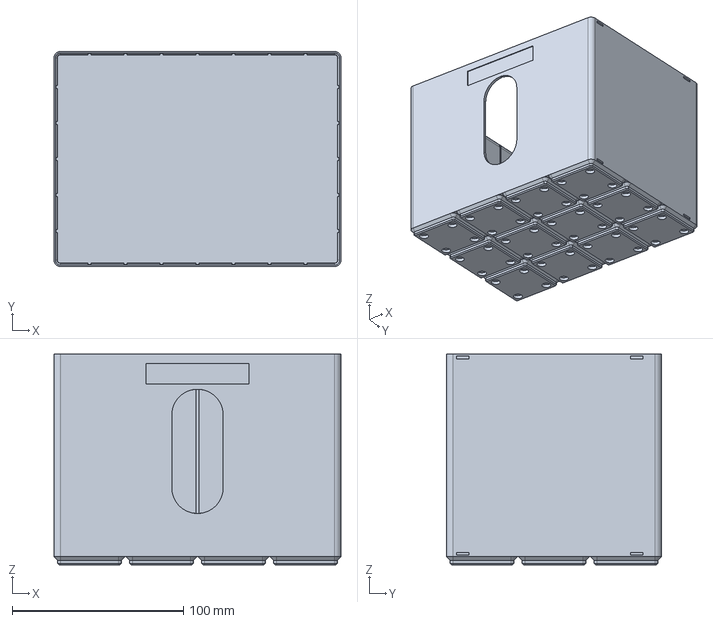
[picture p67: CAD file, 2026-10-02]
models/baglib/step/crate-4x3x17.step
167.5 x 125.5 x 123.0 mm
