micovi/stakee/(list of files, cad)

Other CAD files:
models/crates/step/crate-2x2x3.step
models/baglib/step/card-2x-led.step
models/crates/step/crate-2x2x6.step
models/baglib/step/card-4x-ic.step
models/calibration/step/lip-coupon-25.step
models/baglib/step/card-4x-pwr.step
models/baglib/step/card-4x-misc.step
models/crates/step/crate-3x2x6.step
models/baglib/step/card-2x-misc.step
models/baglib/step/card-2x-conn.step
models/baglib/step/card-2x-mcu.step
models/dividers/step/rail-x-2x2x6.step
models/baglib/step/card-4x-cap.step
models/baglib/step/card-2x-cap.step
models/baglib/step/card-2x-ic.step
models/dividers/step/rail-x-2x2x3.step
models/baglib/step/card-4x-res.step
models/baglib/step/card-4x-conn.step
models/baglib/step/card-2x-pwr.step
models/baglib/step/card-4x-led.step
models/baglib/stl/cap-2x4.stl
models/baglib/stl/cap-4x3.stl
models/baglib/stl/card-2x-cap.stl
models/baglib/stl/card-2x-conn.stl
models/baglib/stl/card-2x-ic.stl
models/baglib/stl/card-2x-led.stl
models/baglib/stl/card-2x-mcu.stl
models/baglib/stl/card-2x-misc.stl
models/baglib/stl/card-2x-pwr.stl
models/baglib/stl/card-2x-res.stl
models/baglib/stl/card-4x-cap.stl
models/baglib/stl/card-4x-conn.stl
models/baglib/stl/card-4x-ic.stl
models/baglib/stl/card-4x-led.stl
models/baglib/stl/card-4x-mcu.stl
models/baglib/stl/card-4x-misc.stl
models/baglib/stl/card-4x-pwr.stl
models/baglib/stl/card-4x-res.stl
models/baglib/stl/crate-2x4x17.stl
models/baglib/stl/crate-4x3x17.stl
models/baglib/stl/follower-2x.stl
models/baglib/stl/follower-4x.stl
models/calibration/stl/lip-coupon-15.stl
models/calibration/stl/lip-coupon-25.stl
models/calibration/stl/lip-coupon-35.stl
models/calibration/stl/lip-probe.stl
models/calibration/stl/slot-samples.stl
models/calibration/stl/slot-strip.stl
models/crates/stl/cap-1x1.stl
models/crates/stl/cap-2x1.stl
models/crates/stl/cap-2x2.stl
models/crates/stl/cap-3x2.stl
models/crates/stl/crate-1x1x3.stl
models/crates/stl/crate-2x1x3.stl
models/crates/stl/crate-2x2x3.stl
models/crates/stl/crate-2x2x6.stl
models/crates/stl/crate-3x2x6.stl
models/dividers/stl/bridge-21-2x2x3.stl
models/dividers/stl/bridge-21-2x2x6.stl
models/dividers/stl/bridge-21-3x2x6.stl
models/dividers/stl/bridge-42-2x2x3.stl
models/dividers/stl/bridge-42-2x2x6.stl
models/dividers/stl/bridge-42-3x2x6.stl
models/dividers/stl/hook-21-2x2x3.stl
models/dividers/stl/hook-21-2x2x6.stl
models/dividers/stl/hook-21-3x2x6.stl
models/dividers/stl/hook-42-2x2x3.stl
models/dividers/stl/hook-42-2x2x6.stl
models/dividers/stl/hook-42-3x2x6.stl
models/dividers/stl/rail-x-2x2x3.stl
models/dividers/stl/rail-x-2x2x6.stl
models/dividers/stl/rail-x-3x2x6.stl
models/dividers/stl/rail-y-2x2x3.stl
models/dividers/stl/rail-y-2x2x6.stl
models/dividers/stl/rail-y-3x2x6.stl
models/drawers/stl/drawer-2x2x3.stl
models/drawers/stl/drawer-2x2x6.stl
models/drawers/stl/rail-x-drawer-2x2x3.stl
models/drawers/stl/rail-x-drawer-2x2x6.stl
models/drawers/stl/rail-y-drawer-2x2x3.stl
models/drawers/stl/rail-y-drawer-2x2x6.stl
models/drawers/stl/sleeve-2x2x3.stl
models/drawers/stl/sleeve-2x2x6.stl
models/esd/stl/esd-crate-2x2x3.stl
models/esd/stl/esd-crate-2x2x6.stl
models/esd/stl/esd-crate-3x2x6.stl
models/inserts/stl/dev-board-dock.stl
models/inserts/stl/parts-grid-2x2.stl
models/inserts/stl/solder-station.stl
models/kit/stl/nfc-cap-2x2.stl
models/kit/stl/nfc-label-tile.stl
models/kit/stl/stack-clip.stl
models/kit/stl/tool-rack-cap-2x2.stl
models/kit/stl/tote-cap-2x2.stl
models/kit/stl/tote-cap-3x2.stl
models/magtray/stl/magtray-2x2.stl
models/magtray/stl/magtray-3x2.stl
models/pocket/stl/pocket-base-2x1x4.stl
models/pocket/stl/pocket-base-2x2x4.stl
models/pocket/stl/pocket-divider-2x1.stl
models/pocket/stl/pocket-divider-2x2.stl
models/pocket/stl/pocket-lid-2x1.stl
models/pocket/stl/pocket-lid-2x2.stl
models/wallrail/stl/shelf-2x1.stl
models/wallrail/stl/shelf-2x2.stl
models/wallrail/stl/shelf-3x2.stl
models/wallrail/stl/shelf-4x1.stl
models/wallrail/stl/wall-cleat-2.stl
models/wallrail/stl/wall-cleat-4.stl
models/wirespool/step/wire-spool-washer-8mm.step
models/wirespool/stl/wire-axle-8mm.stl
models/wirespool/stl/wire-cradle-frame-4x2x9.stl
models/wirespool/stl/wire-dispenser-4x2x9.stl
models/wirespool/stl/wire-spool-washer-8mm.stl
