micovi/stakee/(commit log)

2026-10-02 Restructure into a model library under models/
    Generator writes STL, STEP and SVG line art per family into
    models/<family>/ with a manifest and a generated README page.
    Drops the old landing pages, Astro site and GLB exports.
    [bridge-21-2x2x3.step, bridge-21-2x2x3.stl, bridge-21-2x2x6.step, bridge-21-2x2x6.stl, bridge-21-3x2x6.step, bridge-21-3x2x6.stl, bridge-42-2x2x3.step, bridge-42-2x2x3.stl]
2026-10-02 Rebuild models with white-background previews and stable STEP headers
    Adds tests for the generated pages and build selection, Python CI,
    Dependabot and prek hooks.
    [bridge-21-2x2x3.step, bridge-21-2x2x6.step, bridge-21-3x2x6.step, bridge-42-2x2x3.step, bridge-42-2x2x6.step, bridge-42-3x2x6.step, cap-1x1.step, cap-2x1.step]
2026-10-02 Address Python review: checked exports, safer builds, more tests
    - Raise when an STL/STEP write fails; validate slugs before writing
    - Pin STEP timestamp via export_step and renumber all assembly links
    - build: no swallowed rmtree errors, restore hint on failure,
    --only and --docs-only are exclusive
    - Escape alt text; drop unused PartInfo.assembly and trimesh
    - Split tests per module and cover the error paths
2026-10-02 Merge docs follow-ups: shared lip-clearance limits, accurate part notes
    - CLI rejects lip clearances the geometry refuses (0.15 to <1.0 mm)
    - Crate blurbs show the exact cavity; ESD and wire dispenser notes
    mention the magnet pockets; coupons point to --lip-clearance
    - Calibration's own runner clears stale parts and rewrites the pages
    - Docs updated for the reviewed build and export behaviour
2026-10-02 Add Starlight docs site with catalogue, 3D viewer and configurator
    Astro + Starlight site in site/, built with Bun from models/ and docs/:
    model catalogue with client-side filters, one page per family with a
    three.js STL viewer and parts table, a stakee box configurator ported
    from stakee/core.py and stakee/cli.py, and synced docs pages.
    Deployed to GitHub Pages by .github/workflows/site.yml.
2026-10-02 Configurator: lip clearance limits match the CLI (0.15 to <1.0 mm)
2026-10-02 Site: fix review findings in configurator, viewer, docs sync and CI
    - Configurator: pass the label as --label=TEXT (labels starting with "-"),
    note the POSIX quoting, lip clearance step 0.01, no NaN command for empty
    fields, show 2 label tiles with --cap
    - Viewer: "Show in 3D view" buttons hidden until WebGL is confirmed and start
    the viewer on click; hash changes select the part; release the WebGL probe
    context; render on demand instead of every frame
    - Docs sync: check that repo-relative targets exist, fail on broken or
    absolute links, skip footnotes, code spans and indented code, keep <...>
    around targets with spaces; docs/ is required (drop STAKEE_DOCS_DIR)
    - One SITE_BASE co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
